jklynch/r255tbl_throat_plate/(commit log)

2026-11-01 change to right-handed coordinate system
    The original model was accidentally built with a left-handed
    coordinate system. The print was reversed left-to-right relative
    to the table saw opening.
    [throat_plate.scad]
2026-11-01 Add README with preview renders
    Track preview PNGs (drop *.png from .gitignore) and re-render them from
    the right-handed model.
